Athesto/2017b_ProyectoInstrumentacion/docs/index.md

    Novedades:
    [11-25] Montaje de primeras imagenes en la Galeria
    [27-30] Montaje de videos
    [2-4] actualización masiva de la pagina

## Instrumentación de un sistema de enfriamiento para aclimatación de alimentos ##

> ### Integrantes
>  - David Escalante
>  - Jose Lamadrid
>  - Aldair Benavides
>  - Jose Lopez
>  - Tomas Quintero

### introducción
La conservación de alimentos a lo largo de los tiempos ha desempeñado un papel importante contra la hambruna en el mundo por ende la preservación de la misma es un tema bastante delicado, por lo cual se utilizan métodos de refrigeración comunes y en algunos casos alternativos, tales como, refrigeración magnética y el uso de placas Peltier, este último es bastante atractivo debido a que no funciona por ciclos como los sistemas comunes y poseen un bajo peso además de su capacidad para trabajar a temperaturas criogénicas (menos de 150K). Todas estas ventajas van de la mano con el uso de la instrumentación del mismo montaje, de tal manera que se han llevado a cabo muchos modelos computarizados para la facilidad de preservar los víveres sin necesidad de estar analizando el comportamiento de forma continua. De aquí, nace la implementación de instrumentación industrial y control para la optimización de los procesos en marcha con ayuda de los protocolos de comunicación para Arduino y otros hardware, teniendo en cuenta que su aplicación está en constante crecimiento. 
El sistema de refrigeración con placas Peltier es bastante utilizado debido a que se ha demostrado que el uso de dichas placas son muy útiles para la reducción de la entrada de calor en un sistema frio sin importar cuál sea el escenario, por ende se implementó para el proyecto estudiado, además del uso de termocupla tipo K para la medición de la temperatura en el interior de la cava debido a sus propiedades, vida útil y robustez, el funcionamiento de las placas Peltier puede resultar fácil debido a que hay que disipar el calor de un lado para que el otro lado se enfrié mucho más, por lo cual se necesitó el uso  de un disipador, que fuera capaz de refrigerar a una máxima capacidad el lado caliente de la placa, todo esto, estaba introducido en el interior de la cava, para poder refrigerarlo con completo, la instrumentación del montaje se produce gracias a un sensor colocado dentro de la cava, que se calibró por medio de ensayo error, aunque también se pudo haber utilizado de manera teórica por medio de la curva de calibración asumiendo que una parte del sensor se encuentra a 0°, cuya sistematización se logró por el uso de la fórmula del sensor hallada en el datasheet del mismo el cual va conectado con el arduino y muestra el valor real dentro de la cava a una pantalla de control. El set point del sistema fue elegido, y se mantuvo durante el proceso, cuando este llegaba a una temperatura por debajo a la deseada se detenía de forma gradual el ventilador usado y cuando estaba por encima se aumentaban las rpm del mismo, todo esto controlado por el sistema de adquisición de arduino.

### Descripción del equipo
Los sistemas de acondicionamiento y refrigeración, son utilizados ampliamente en campos farmacéuticos, químicos e industrias donde se presentan reacciones que dan a condiciones específicas, e incluso en campos que son aparentemente sencillos pero importantes como lo son los alimentos. Es tal la importancia de estos procesos y los avances tecnológicos que suele utilizarse procesos de automatización y control para dichos procesos. 

En el siguiente trabajo se presentó un procesos de refrigeración instrumentando el cual cuenta con el uso de una termocupla tipo k modelo MAX-6675 el cual posee un gran amplio de trabajo comprendido entre 0-1024°C además de 8 pines, además de ser manipulado por el micro controlador de Arduino utilizado el lenguaje de programación libre y el datasheet del sensor para su correcto funcionamiento, todo con el fin de controlar la temperatura en el interior de una cava mediante el uso de células Peltier, para comprobar y corroborar el uso de métodos de refrigeración alternativo implementando los conocimientos de instrumentación industrial.
### Container
Container
### Oled y Shield de arduino
oledshield
### Disipador interno
int disipador Disipador interno.png
### Disipador externo
larger disip Disipador exter.png
### Botones y transistores
Botones

### Soldando shield de arduino

Shield

### Paso a paso
 - Instalar El programa de Arduino
 - Descargar el archivo Zip
 - Programar el display oled
 - calibración del sensor de temperatura
 - Realización un prototipo del circuito haciendo uso de una protoboard
 - Fabricación de un shield para el arduino en base al circuito diseñado en la protoboard con sus respectivas mejoras
 - Fabricación del contenedor e instalación de la unidad de enfriamiento
 - prueba de la capacidad de enfriamiento a diferentes temperaturas ambiente
 - Elaboración del programa para tener control sobre el equipo
 - Pruebas llevadas a cabo haciendo uso del controlador de arduino

### Lista de Materiales (BOM)

| Name 			| Documentación |
|:---			|:---|
| Arduino Uno  			| [webpage](https://store.arduino.cc/usa/arduino-uno-rev3)			 | 
| Display Oled 			| [datasheet](http://www.buydisplay.com/download/manual/ER-OLED0.96_Series_Datasheet.pdf)|
| Max6675 	 			| [datasheet](https://cdn-shop.adafruit.com/datasheets/MAX6675.pdf) |
| Celda Termoelectrica	| [datasheet](http://peltiermodules.com/peltier.datasheet/TEC1-12706.pdf) |

### Galeria [Pendiente]
#### Esquemático
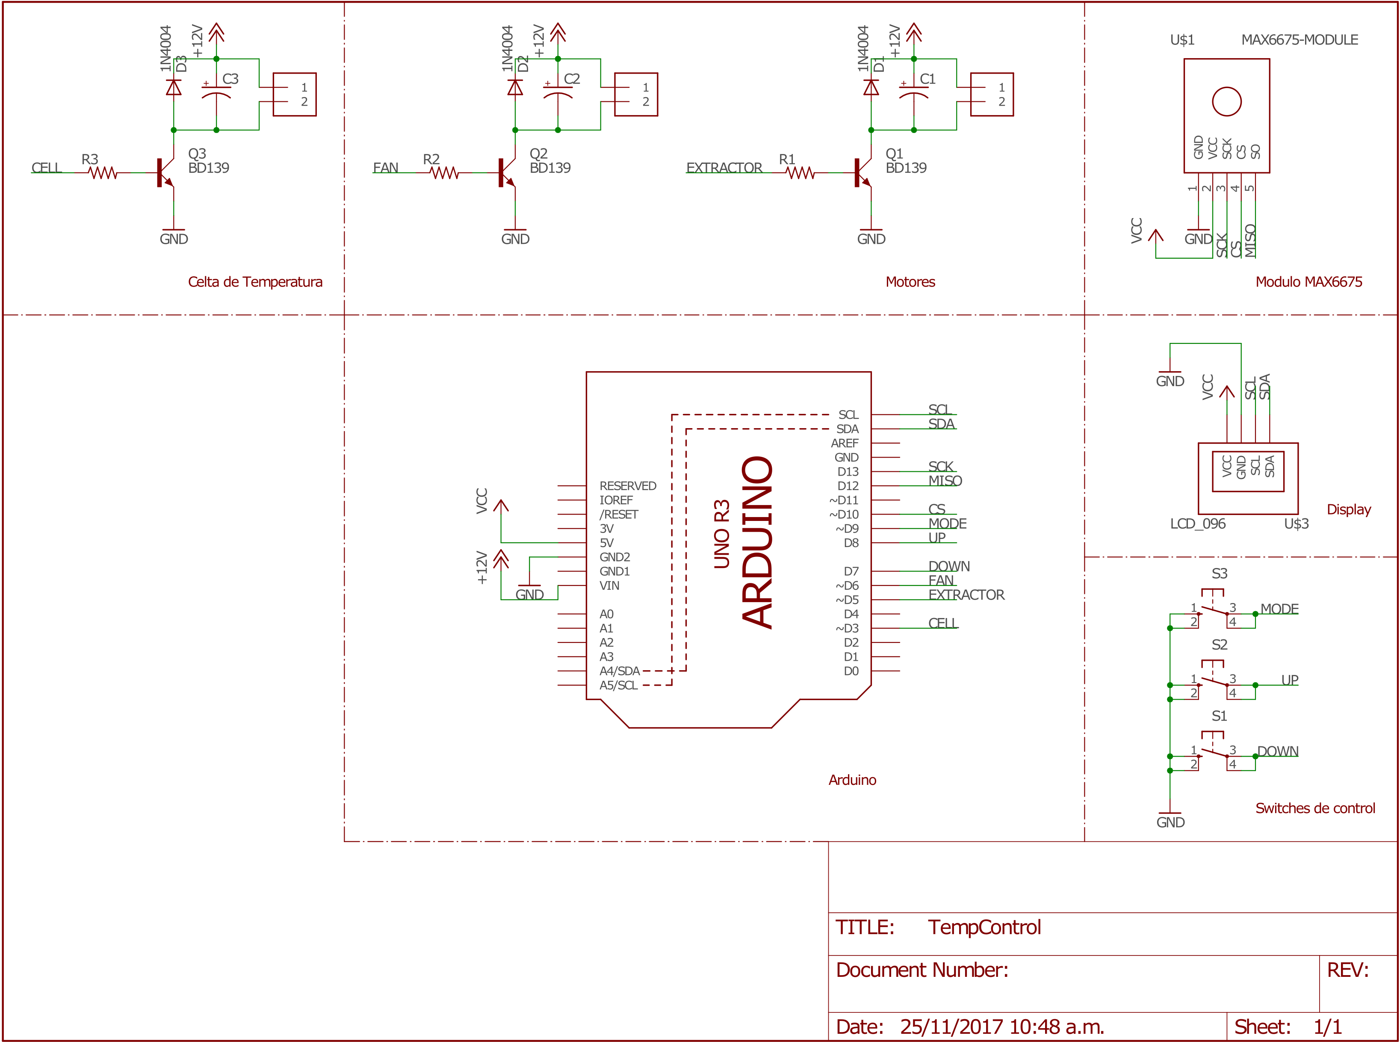
[picture p1: docs/images/schematic.png]
Esquemático

#### Board
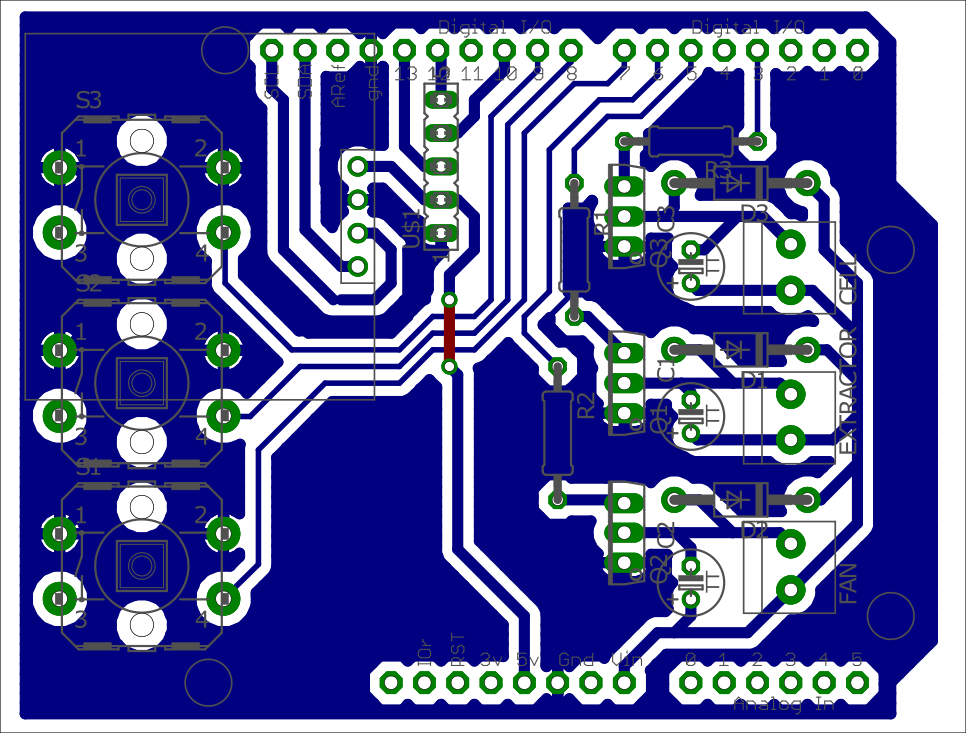
[picture p2: docs/images/board_Bottom.png]
PCB


#### Videos
Prueba del display oled

Prueba display oled (https://www.youtube.com/watch?v=y6lbMbByo7U)

Prueba del disipador

prueba de disipador (https://www.youtube.com/watch?v=Y1n8YhKl0UA)

Prueba de la unidad de enfriamiento

prueba unidad de enfriamiento (https://www.youtube.com/watch?v=jfa_FpGiS5M)

Equipo trabajando en perfectas condiciones

Final test (https://www.youtube.com/watch?v=4yjja9RJj-U)

## Preguntas Frecuentes ##

### Selección de sensores. (error estático y dinámico)
Error de 0.75 en estado transitorio, dado que el aire al interior del contenedor está en constante circulación, por esto la temperatura del contenedor no posee una temperatura totalmente uniforme durante el estado de transición.

RTD vs termopar- RTD superior en la mayoría de aspectos excepto por la robustez, tamaño, velocidad de respuesta y precio.

### Adquisición de datos y acondicionamiento de señal (circuitos de acondicionamiento y elementos asociados a las características del procesador).

Se hace uso de un circuito integrado (Max6675) usado como intermediario entre el sensor (termocupla) y el controlador (arduino uno) para convertir la señal analógica en una señal digital (ADC). El max6675 hace uso de un amplificador, un diodo de compensación (bloque isotermo), buffer de voltaje y un ADC.
El max6675 envía una señal digital al ardiuno, la cual se interpreta por medio de una librería previamente instalada.

### Calibración de sensores, cálculo de errores e incertidumbre.
La calibración del sensor lo hace internamente el arduino, con las librerías internas que están en el, podemos decir lo que esta realizando internamente es lo siguiente, a conocer una de las temperaturas de alguna de las 2 uniones y al hacer la otra unión 0°C, por medio de la ley de temperaturas intermedias y buscando en las tablas conseguir el valor de tensión al que debe estar la termocupla.

## Anécdotas ##

 1. Durante la fase de pruebas de la unidad de enfriamiento junto con el controlador (arduino), se presento un contratiempo, dado que la celda peltier exige un alto nivel de corriente (4.5 A)  mientras que el transistor restringía el paso de la corriente, la corriente al no poder seguir su camino hacia la celda, Causando una averia en el reculador de voltaje del controlador (arduino).
 2. Al realizar el prototipo del circuito haciendo uso de la protoboard, un par de cables que no estaban completamente aislados, hicieron contacto, de tal forma que se cerro el circuito, sin ninguna resistencia, ocasionando un corto circuito, el cual tuvo como consecuencia una avería catastrófica en el transistor de prueba.

# Development
## Links de interés
 - [Theme Template](https://pages-themes.github.io/slate/)
 - [Online Editor](https://stackedit.io/editor#)
 - [Theme Manual](https://github.com/pages-themes/slate)
 - [Jekyll DOC](http://import.jekyllrb.com/docs/home/) 
 - [Themes](http://jekyllthemes.org/)
