Athesto/2017b_ProyectoInstrumentacion/BOARD/SCHEMATIC.pdf

# GND ⁺¹²V

# BD139 ¹N⁴⁰⁰⁴ +¹²V

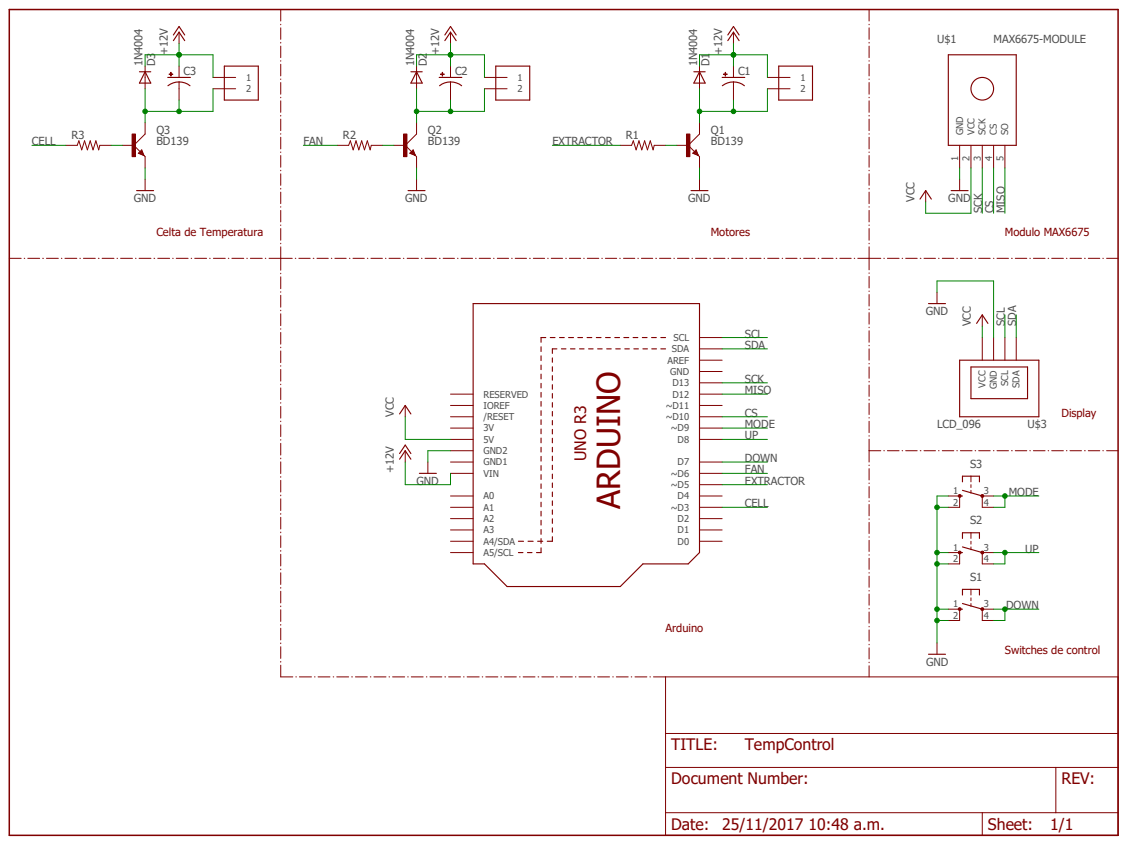
[picture p3: page 1]

5 U$1 VCC GND SCL SDA

Document Number: | REV:

Date: 25/11/2017 10:48 a.m. | Sheet: 1/1
