Athesto/2017b_ProyectoInstrumentacion/BOARD/BOARD.pdf

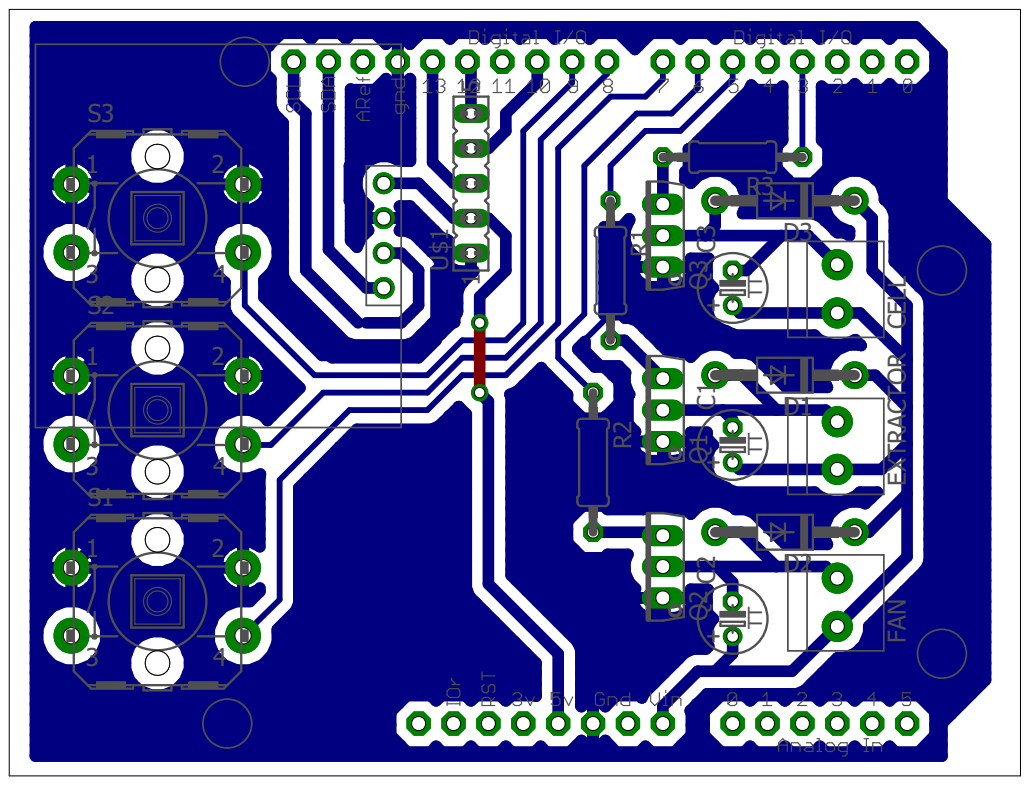
[picture p4: page 1]
EXTRACTOR; FAN C2 Q³; CELL C3
