Athesto/2017b_ProyectoInstrumentacion/BOARD/TempControl/TempControl .brd

## EAGLE design BOARD/TempControl/TempControl .brd (2017-12-03)

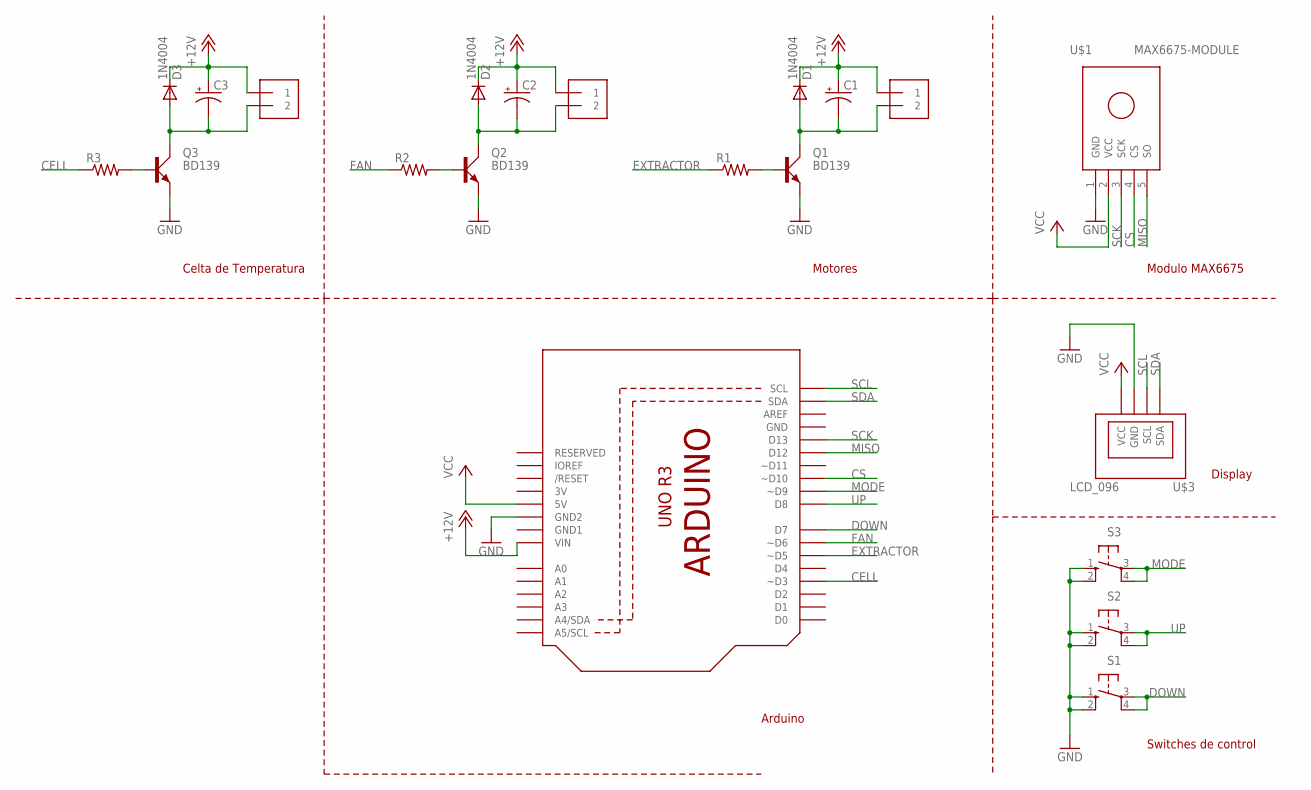
[picture p5: schematic TempControl .sch]

Parts:
C1, C2, C3: CPOL-USTT2D5; TT2D5
CELL: 1X2-3.5MM
D1, D2, D3: 1N4004; DO41-10
EXTRACTOR: 1X2-3.5MM
FAN: 1X2-3.5MM
Q1, Q2, Q3: BD139; TO126AV
R1, R2, R3: R-US_0207/10; 0207/10
S1, S2, S3: 40-XX-ROUND; B3F-40XX-ROUND
U1: ARDUINOR3-BPLACE
U$1: MAX6675-MODULE; FE05-1
U$3: LCD_096; LCD_096"

Connections:
3V: U1.3V
+12V: C1.+, C2.+, C3.+, CELL.1, D1.C, D2.C, D3.C, EXTRACTOR.1, FAN.1, U1.VIN
CELL: R3.1, U1.D3 (~D3)
CS: U1.D10 (~D10), U$1.4 (CS)
DOWN: S1.3, S1.4 (P1), U1.D7
EXTRACTOR: R1.1, U1.D5 (~D5)
FAN: R2.1, U1.D6 (~D6)
GND: Q1.E, Q2.E, Q3.E, S1.1 (S), S1.2 (S1), S2.1 (S), S2.2 (S1), S3.1 (S), S3.2 (S1), U1.GND, U1.GND2, U$1.1 (GND), U$3.P$2 (GND)
GND1: U1.GND1
MISO: U1.D12, U$1.5 (SO)
MODE: S3.3, S3.4 (P1), U1.D9 (~D9)
unnamed: C2.-, D2.A, FAN.2, Q2.C
unnamed: C1.-, D1.A, EXTRACTOR.2, Q1.C
unnamed: Q1.B, R1.2
unnamed: Q2.B, R2.2
unnamed: C3.-, CELL.2, D3.A, Q3.C
unnamed: Q3.B, R3.2
SCK: U1.D13, U$1.3 (SCK)
SCL: U1.SCL, U$3.P$3 (SCL)
SDA: U1.SDA, U$3.P$4 (SDA)
UP: S2.3, S2.4 (P1), U1.D8
VCC: U1.5V, U$1.2 (VCC), U$3.P$1 (VCC)

Notes on the sheet:
Modulo MAX6675
Switches de control
Display
Motores
Arduino
Celta de Temperatura

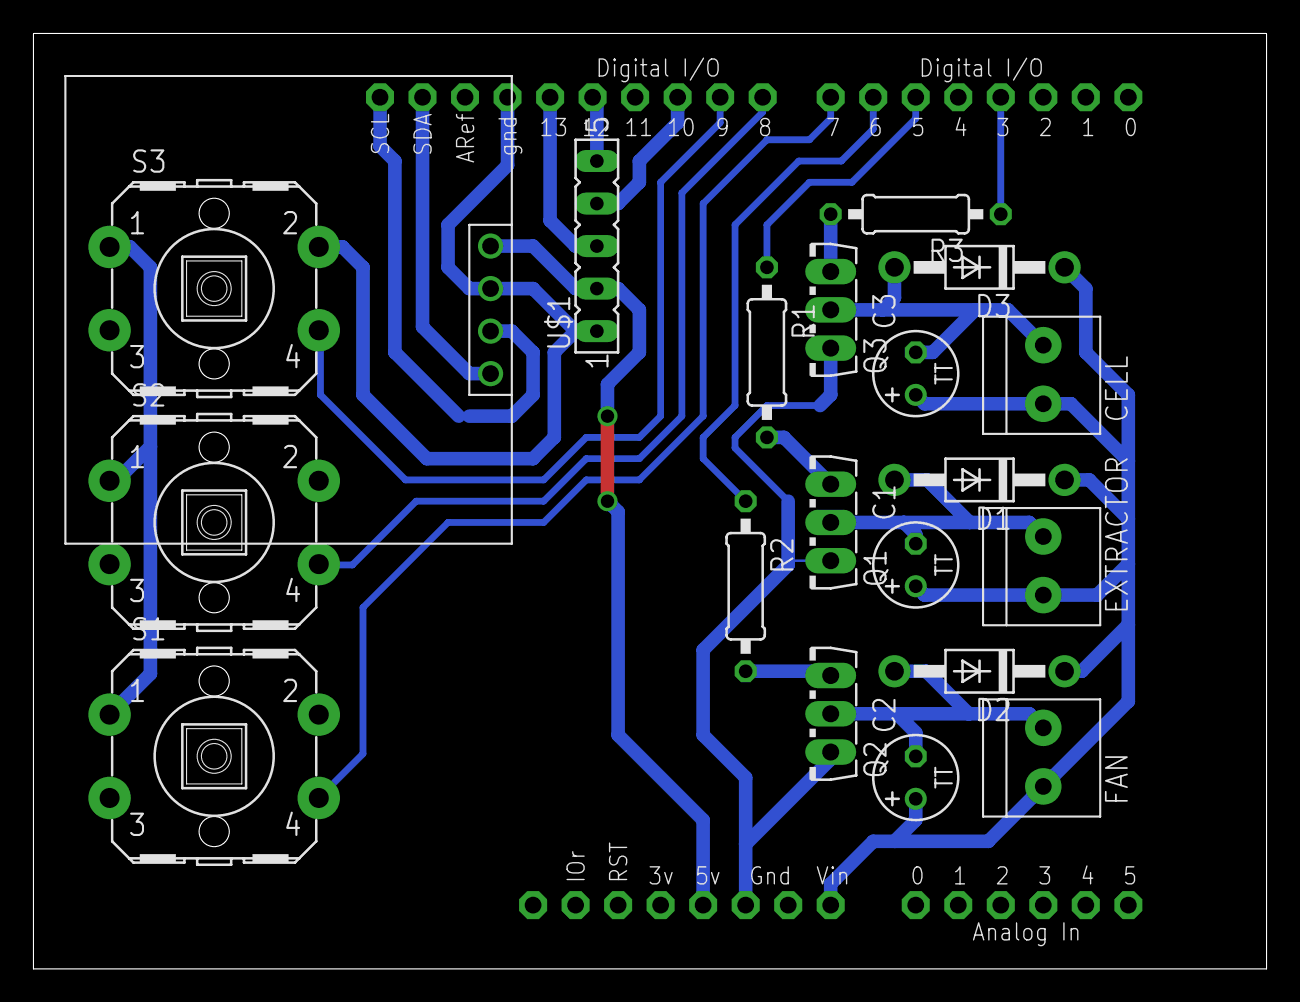
[picture p6: board TempControl .brd from above]

Board: 2 copper layers, 73.7 x 55.9 mm, 21 parts (0 on the bottom side), 20 nets.
