Athesto/2017b_ProyectoInstrumentacion/(commit log)

2017-11-16 WebPage
    - Se prueba la página
    - Se añade el título, descripción y tema
2017-11-25 PCB file
    [TempControl .brd, TempControl .sch]
2017-11-25 Web: BOM
    - Se hace la Galería
2017-11-25 Web: Galeria
    - Se cambió la posicion de las sección de desarrollo
    - update: imagen del esquemático
    - added: Novedades
2017-12-03 miniors changes
    [TempControl .brd]
2017-12-03 Demos
    - AnaogTest
    - DisplayTest
    - Timers
2017-12-05 Webpage: Transistor to BOM
2017-12-06 fix program
    El programa solo actualizaba si cambiaban el setpoint
    [TempControl.ino]
